PARSES-Lab/scans/CAD/Finger/STEP/Finger_Assembly.STEP

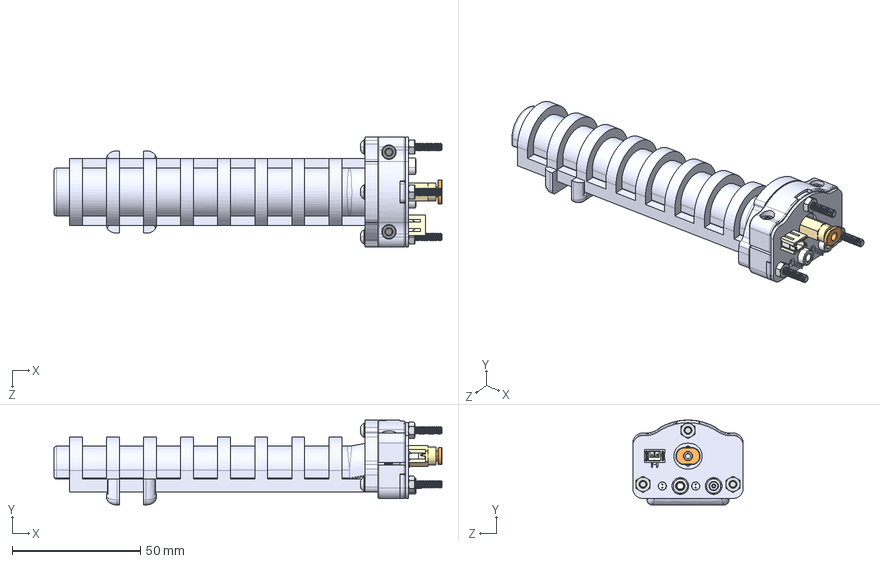
[picture p1: CAD file, 2025-10-14]
CAD/Finger/STEP/Finger_Assembly.STEP
151.0 x 33.0 x 43.0 mm
TPU_Exoskeleton
Finger_Bladder_Angled
Waveguide_Fiber
Cladded_Fiber_Shorter Fiber
Cladded_Fiber_Longer Fiber
TPU_Prism x 2
Connector_Clamp_Top
Connector_Clamp_Bottom_Bottom Cutout
Connector_Clamp_Back_Larger Plate
PCB_Blank_Right Angle Mount
Fingertip_Spacer_Standoff_5mm with legs thick x 2
3mm_Prism x 2
SMA connector x 2
KQ2H01-M5A1_part
QTH_Bulb x 2
B2B-PH-SM4-TB
94180A331_Tapered Heat-Set Inserts for Plastic_94180A331 x 2
90591A250_Zinc-Plated Steel Hex Nut_90591A250 x 3
91290A113_Alloy Steel Socket Head Screw_91290A113 x 2
91306A725_Button Head Hex Drive Screws_91306A725 x 3
