PARSES-Lab/scans/CAD/Cladding_Mold/STEP/Cladding_Assembly.STEP

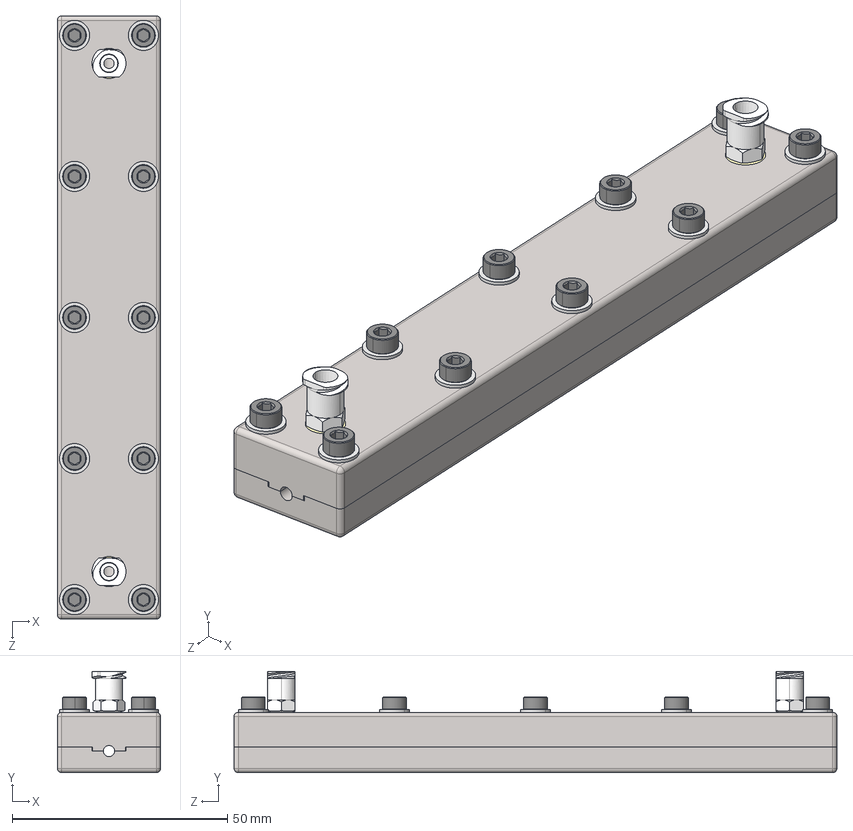
[picture p2: CAD file, 2025-10-14]
CAD/Cladding_Mold/STEP/Cladding_Assembly.STEP
24.0 x 23.5 x 140.0 mm
Fiber_Cladding_Mold_Bottom_washer clamp
Fiber_Cladding_Mold_Top_washer clamp
93365A240_10-32 heat set inserts_93365A240 x 2
94180A331_Tapered Heat-Set Inserts for Plastic_94180A331 x 10
51525K235_Plastic Quick-Turn Tube Coupling_51525K235 x 2
91290A117_M3x12 socket head bolt_91290A117 x 10
93475A210_18-8 Stainless Steel Washer_93475A210 x 10
