PARSES-Lab/scans/CAD/Gripper/STEP/Gripper_Assembly.STEP

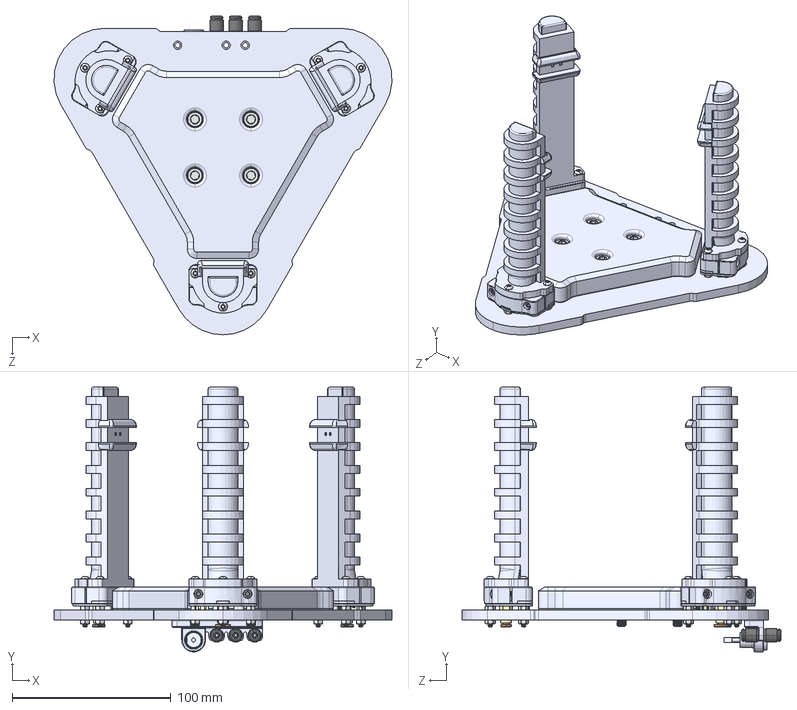
[picture p3: CAD file, 2025-10-14]
CAD/Gripper/STEP/Gripper_Assembly.STEP
213.0 x 166.8 x 200.8 mm
Baseplate_1d_spacing
TPU_Exoskeleton x 3
Finger_Bladder_Angled x 3
Waveguide_Fiber x 3
Cladded_Fiber_Shorter Fiber x 3
Cladded_Fiber_Longer Fiber x 3
TPU_Prism x 6
Connector_Clamp_Top x 3
Connector_Clamp_Bottom_Bottom Cutout x 3
Connector_Clamp_Back_Larger Plate x 3
PCB_Blank_Right Angle Mount x 3
Fingertip_Spacer_Standoff_5mm with legs thick x 6
3mm_Prism x 6
SMA connector x 6
KQ2H01-M5A1_part x 3
QTH_Bulb x 6
B2B-PH-SM4-TB x 3
94180A331_Tapered Heat-Set Inserts for Plastic_94180A331 x 6
90591A250_Zinc-Plated Steel Hex Nut_90591A250 x 18
91290A113_Alloy Steel Socket Head Screw_91290A113 x 6
91306A725_Button Head Hex Drive Screws_91306A725 x 9
Pneumatic_and_Electrical_Harness
Palm_Spacer
91292A135_18-8 Stainless Steel Socket Head Screw_91292A135 x 4
Panel Mount Barrel Terminal
5779K11_Push-to-Connect Tube Fitting for Air_5779K11 x 3
