PARSES-Lab/scans/CAD/Cladding_Mold/STEP/Cladded_Fiber_Cutting_Jig.STEP

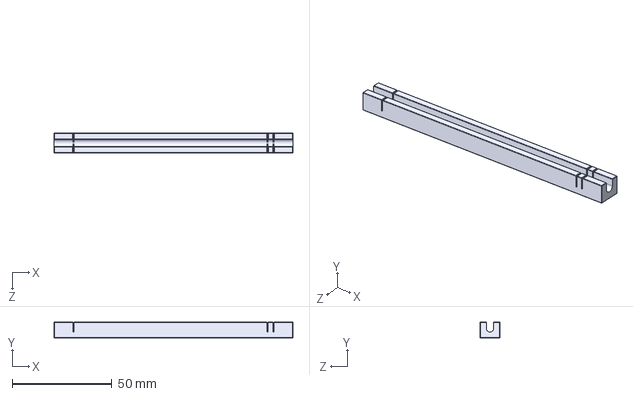
[picture p5: CAD file, 2025-10-14]
CAD/Cladding_Mold/STEP/Cladded_Fiber_Cutting_Jig.STEP
120.0 x 8.00 x 10.0 mm
