PARSES-Lab/scans/CAD/Finger/STEP/Connector_Clamp_Top.STEP

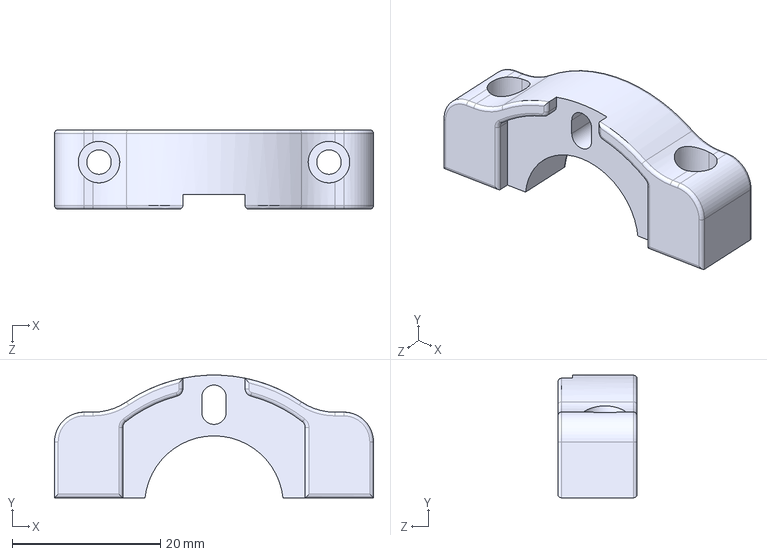
[picture p6: CAD file, 2025-10-14]
CAD/Finger/STEP/Connector_Clamp_Top.STEP
43.0 x 16.5 x 10.7 mm
