PARSES-Lab/scans/CAD/Gripper/STEP/Baseplate_Blank.STEP

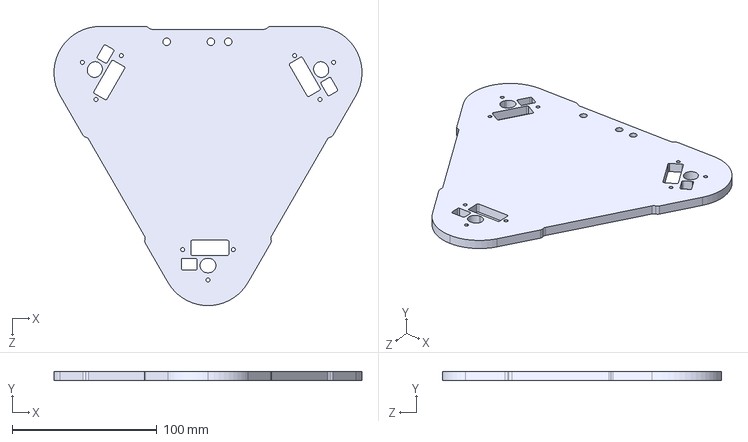
[picture p7: CAD file, 2025-10-21]
CAD/Gripper/STEP/Baseplate_Blank.STEP
213.1 x 6.35 x 193.2 mm
