PARSES-Lab/scans/CAD/Bladder_Mold/STEP/Bladder_Mold_Cap.STEP

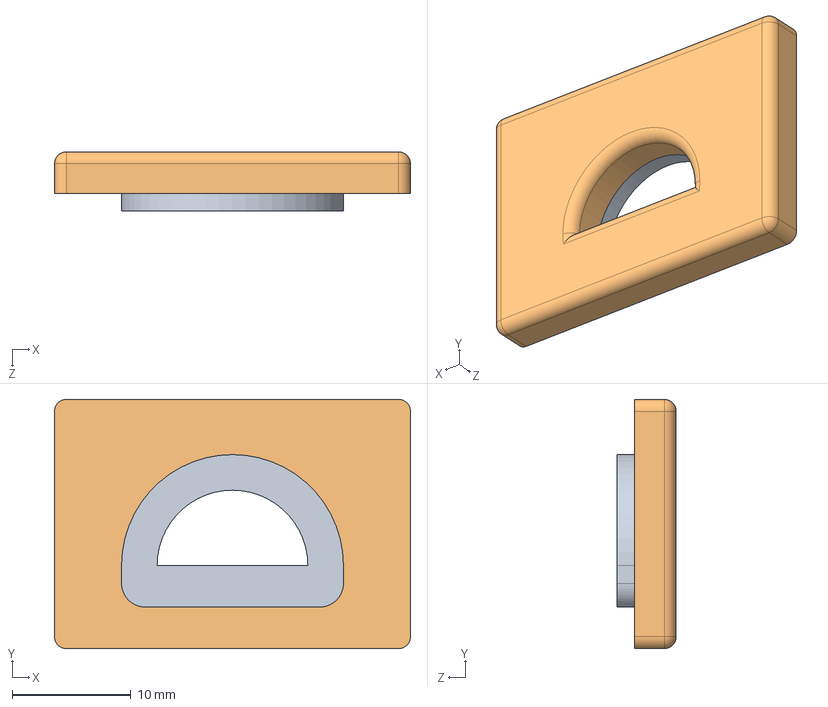
[picture p8: CAD file, 2025-10-14]
CAD/Bladder_Mold/STEP/Bladder_Mold_Cap.STEP
30.0 x 21.0 x 5.00 mm
