PARSES-Lab/scans/CAD/Cladding_Mold/STEP/Fiber_Cladding_Mold_Bottom.STEP

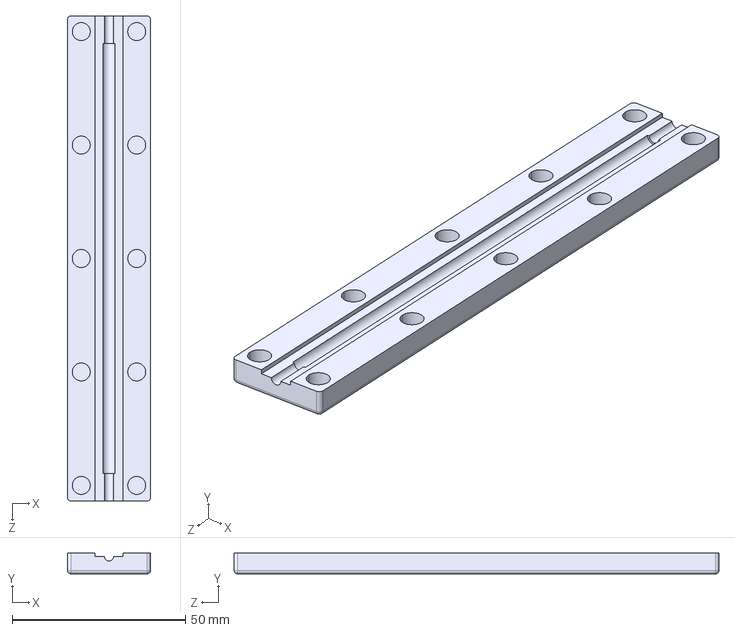
[picture p9: CAD file, 2025-10-14]
CAD/Cladding_Mold/STEP/Fiber_Cladding_Mold_Bottom.STEP
24.0 x 6.00 x 140.0 mm
