PARSES-Lab/scans/CAD/Gripper/STEP/Pneumatic_and_Electrical_Harness.STEP

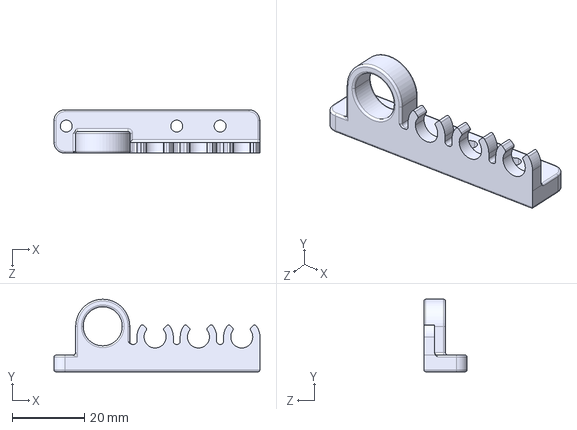
[picture p10: CAD file, 2025-10-14]
CAD/Gripper/STEP/Pneumatic_and_Electrical_Harness.STEP
57.1 x 20.1 x 12.0 mm
