PARSES-Lab/scans/CAD/Bladder_Mold/STEP/Bladder_Mold_Top.STEP

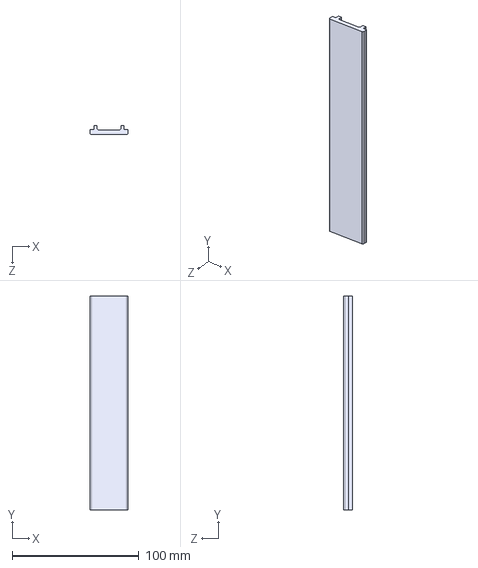
[picture p11: CAD file, 2025-10-14]
CAD/Bladder_Mold/STEP/Bladder_Mold_Top.STEP
30.0 x 169.0 x 7.00 mm
