PARSES-Lab/scans/CAD/Finger/STEP/Fingertip_Spacer_Standoff.STEP

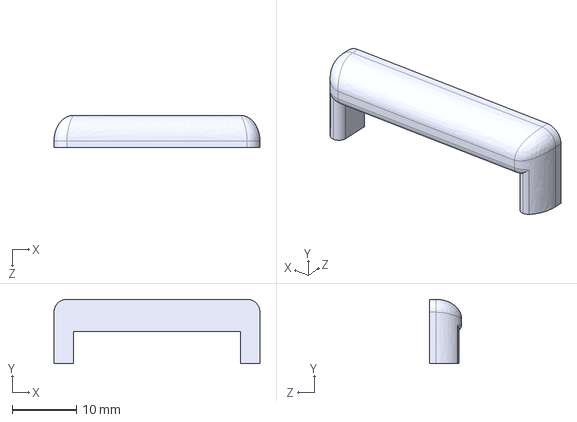
[picture p12: CAD file, 2025-10-14]
CAD/Finger/STEP/Fingertip_Spacer_Standoff.STEP
32.0 x 10.0 x 5.00 mm
