PARSES-Lab/scans/CAD/Bladder_Mold/STEP/Bladder_Mold_Bottom.STEP

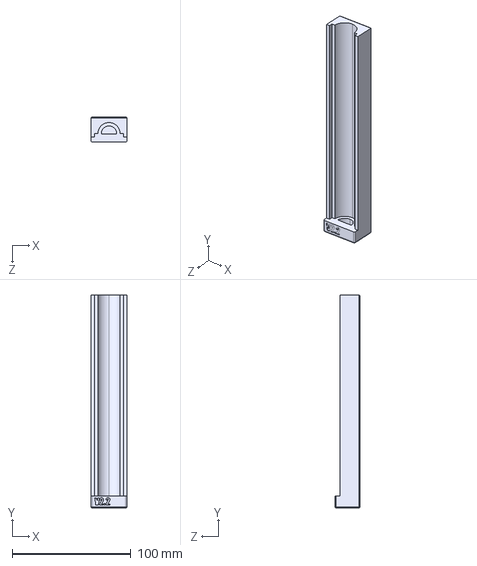
[picture p13: CAD file, 2025-10-14]
CAD/Bladder_Mold/STEP/Bladder_Mold_Bottom.STEP
30.0 x 179.0 x 21.0 mm
