PARSES-Lab/scans/CAD/Cladding_Mold/STEP/Prism_Jig.STEP

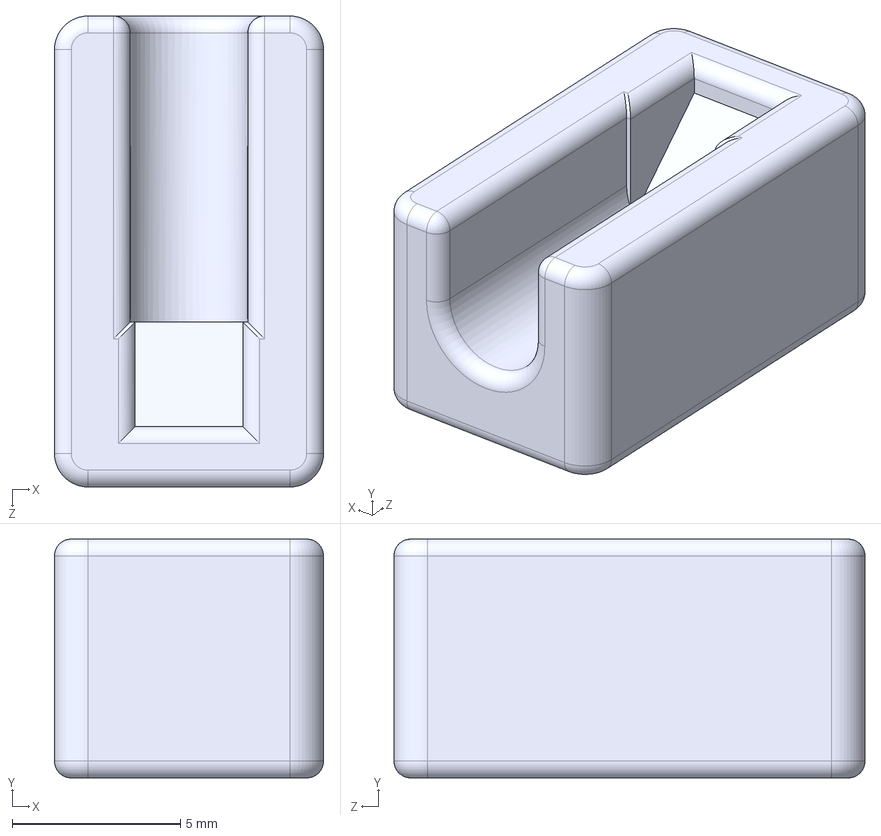
[picture p14: CAD file, 2025-10-14]
CAD/Cladding_Mold/STEP/Prism_Jig.STEP
8.00 x 7.10 x 14.0 mm
