PARSES-Lab/scans/CAD/Finger/STEP/TPU_Exoskeleton.STEP

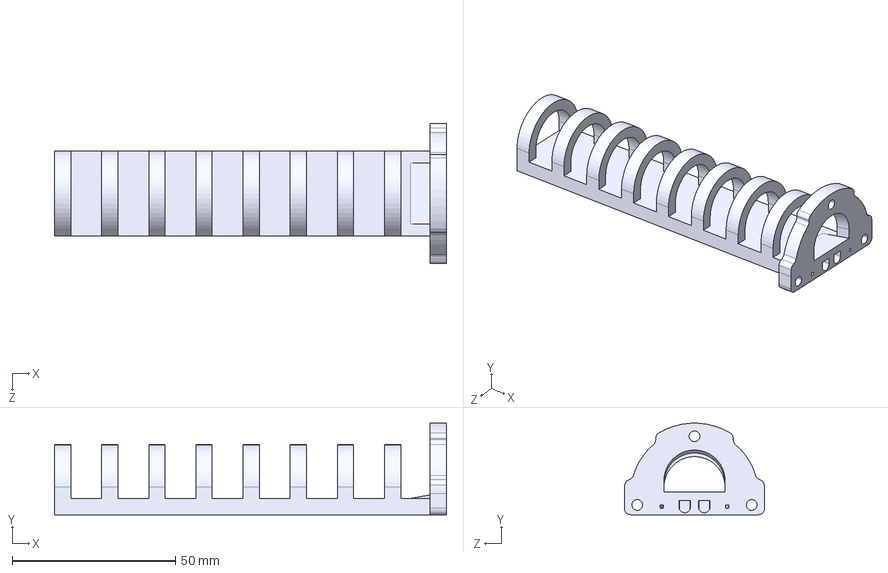
[picture p15: CAD file, 2025-10-14]
CAD/Finger/STEP/TPU_Exoskeleton.STEP
120.0 x 28.0 x 43.0 mm
