PARSES-Lab/scans/CAD/Gripper/STEP/Palm_Spacer.STEP

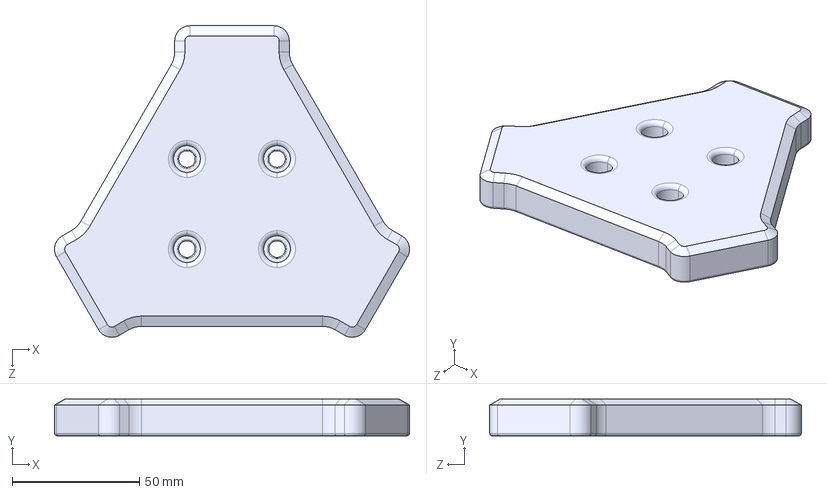
[picture p16: CAD file, 2025-10-14]
CAD/Gripper/STEP/Palm_Spacer.STEP
139.3 x 14.4 x 122.3 mm
