PARSES-Lab/scans/CAD/Bladder_Mold/STEP/Bladder_Cutting_Tool_5deg.STEP

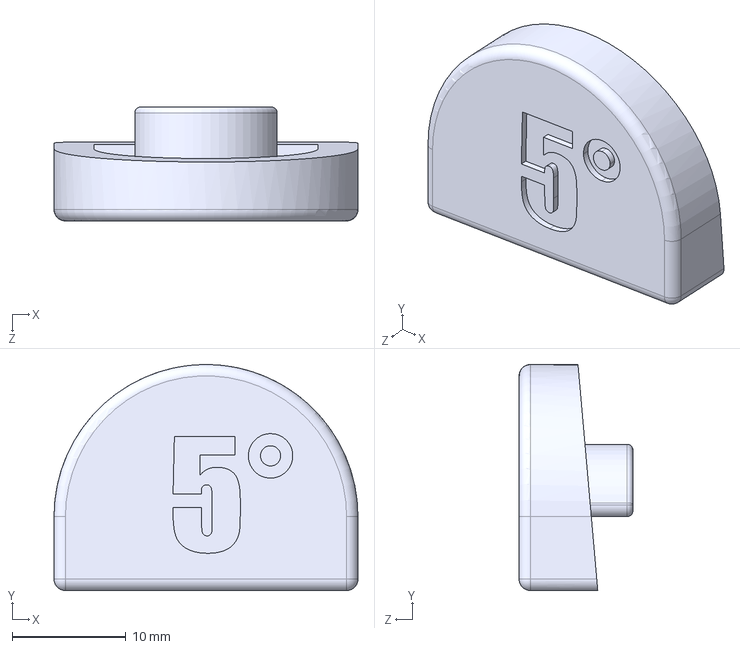
[picture p17: CAD file, 2025-10-14]
CAD/Bladder_Mold/STEP/Bladder_Cutting_Tool_5deg.STEP
26.7 x 19.9 x 10.0 mm
