PARSES-Lab/scans/CAD/Cladding_Mold/STEP/Fiber_Cladding_Mold_Top.STEP

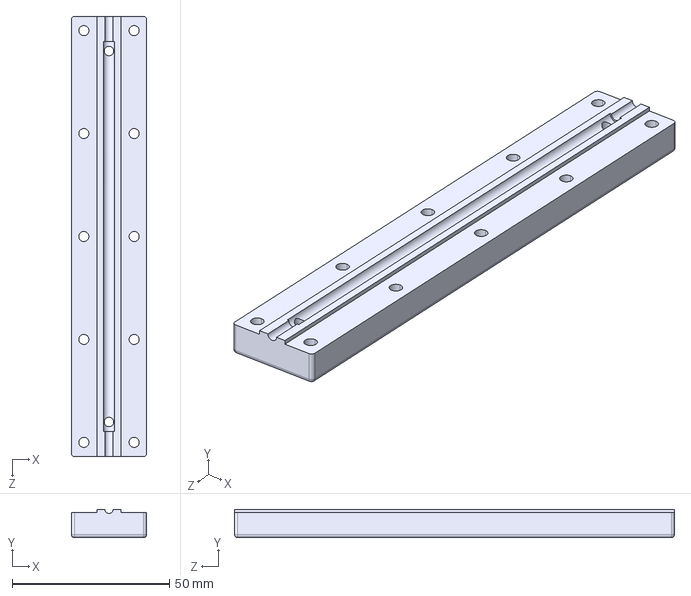
[picture p18: CAD file, 2025-10-14]
CAD/Cladding_Mold/STEP/Fiber_Cladding_Mold_Top.STEP
24.0 x 9.00 x 140.0 mm
