PARSES-Lab/scans/CAD/Finger/STEP/Connector_Clamp_Back.STEP

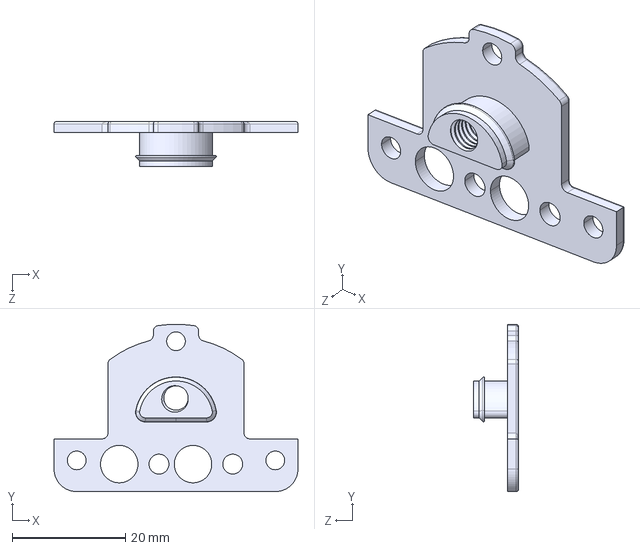
[picture p19: CAD file, 2025-10-14]
CAD/Finger/STEP/Connector_Clamp_Back.STEP
43.0 x 29.5 x 8.00 mm
