PARSES-Lab/scans/CAD/Finger/STEP/TPU_Prism.STEP

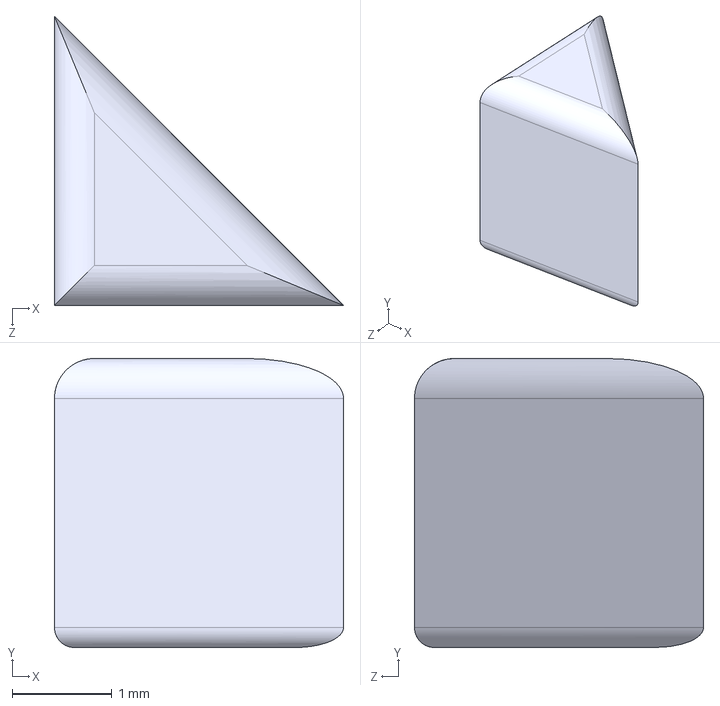
[picture p20: CAD file, 2025-10-14]
CAD/Finger/STEP/TPU_Prism.STEP
2.90 x 2.90 x 2.90 mm
