PARSES-Lab/scans/CAD/Finger/STEP/Waveguide_Cutting_Jig.STEP

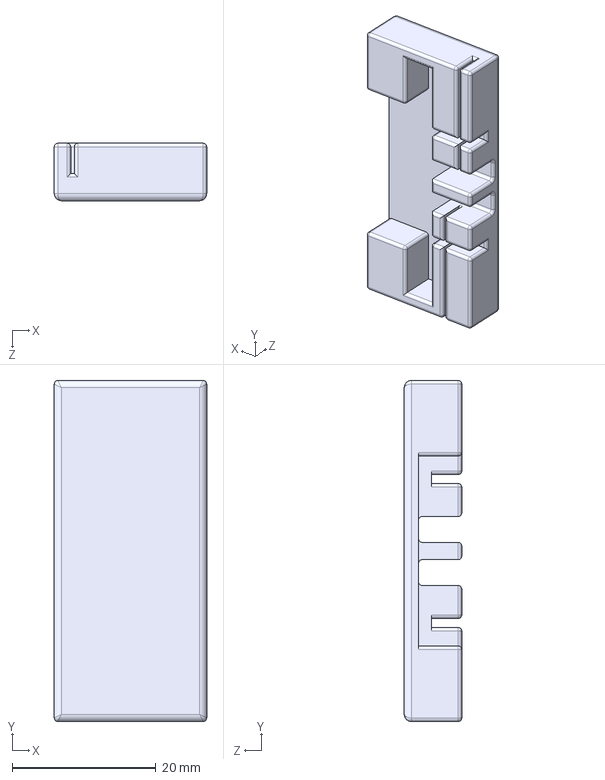
[picture p21: CAD file, 2025-10-14]
CAD/Finger/STEP/Waveguide_Cutting_Jig.STEP
21.2 x 47.4 x 8.00 mm
