PARSES-Lab/scans/CAD/Finger/STEP/Connector_Clamp_Bottom.STEP

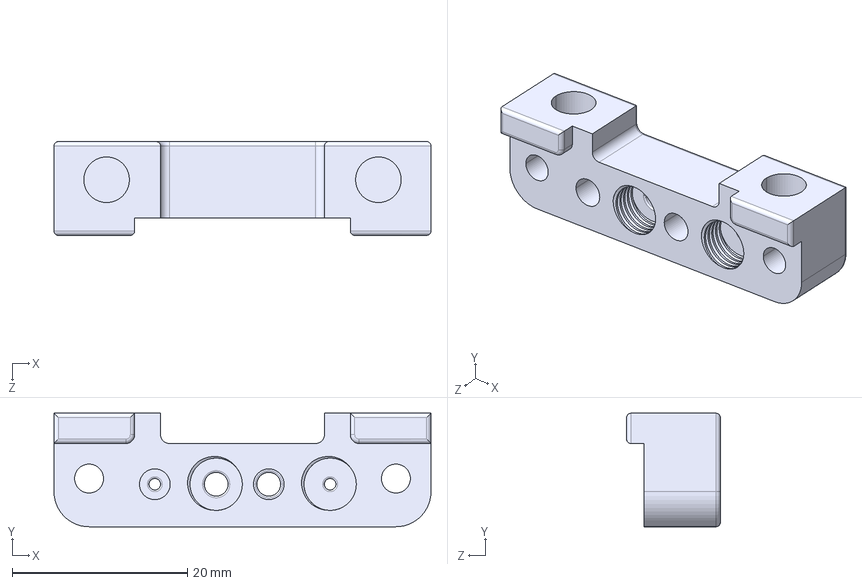
[picture p22: CAD file, 2025-10-14]
CAD/Finger/STEP/Connector_Clamp_Bottom.STEP
43.0 x 13.0 x 10.7 mm
