PARSES-Lab/scans/CAD/Finger/STEP/White_Calibration_Mount.STEP

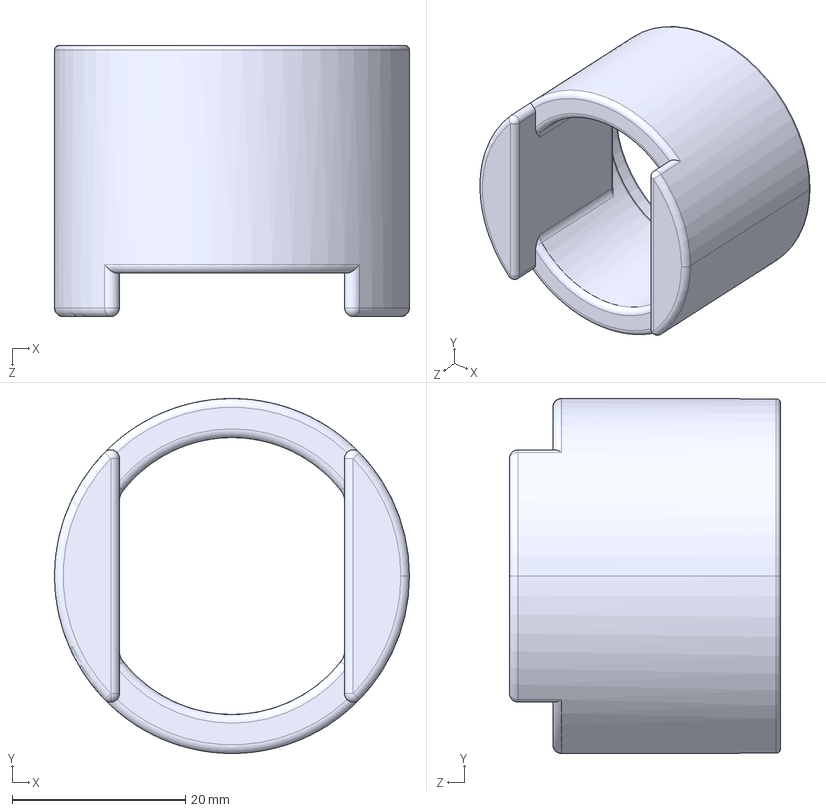
[picture p23: CAD file, 2025-10-14]
CAD/Finger/STEP/White_Calibration_Mount.STEP
41.0 x 41.0 x 31.3 mm
