PARSES-Lab/scans/(list of files, cad)

Other CAD files:
CAD/Gripper/STEP/Baseplate.STEP
CAD/Bladder_Mold/STL/Bladder_Cutting_Tool_0deg.STL
CAD/Bladder_Mold/STL/Bladder_Cutting_Tool_5deg.STL
CAD/Bladder_Mold/STL/Bladder_Mold_Bottom.STL
CAD/Bladder_Mold/STL/Bladder_Mold_Cap.STL
CAD/Bladder_Mold/STL/Bladder_Mold_Top.STL
CAD/Cladding_Mold/STL/Cladded_Fiber_Cutting_Jig.STL
CAD/Cladding_Mold/STL/Fiber_Cladding_Mold_Bottom.STL
CAD/Cladding_Mold/STL/Fiber_Cladding_Mold_Top.STL
CAD/Cladding_Mold/STL/Prism_Jig.STL
CAD/Finger/STL/Connector_Clamp_Back.STL
CAD/Finger/STL/Connector_Clamp_Bottom.STL
CAD/Finger/STL/Connector_Clamp_Top.STL
CAD/Finger/STL/Fingertip_Spacer_Standoff.STL
CAD/Finger/STL/TPU_Exoskeleton.STL
CAD/Finger/STL/TPU_Prism.STL
CAD/Finger/STL/Waveguide_Cutting_Jig.STL
CAD/Finger/STL/White_Calibration_Mount.STL
CAD/Gripper/STL/Baseplate.STL
CAD/Gripper/STL/Palm_Spacer.STL
CAD/Gripper/STL/Pneumatic_and_Electrical_Harness.STL
