PARSES-Lab/scans/(commit log)

2025-10-14 moved CAD folder
    [Baseplate.STEP, Baseplate.STL, Bladder_Cutting_Tool_0deg.STEP, Bladder_Cutting_Tool_0deg.STL, Bladder_Cutting_Tool_5deg.STEP, Bladder_Cutting_Tool_5deg.STL, Bladder_Mold_Bottom.STEP, Bladder_Mold_Bottom.STL]
2025-10-21 moved CAD files and added blank baseplate
    [Baseplate_Blank.STEP]
